HYP3R-08/AuthLog/(commit log)

2026-03-31 integrazione distanza e led
2026-07-16 feat(supabase): add verify-access Edge Function and schema
    The function verifies a UUID against the authorized table and records the
    attempt, keeping the service role key server-side. Devices authenticate
    with a rotatable device token.
    Adds the database schema and the Row Level Security policies.
2026-07-16 refactor(firmware)!: split sketches per board and harden
    Each sketch now lives in its own folder, as the Arduino toolchain requires.
    The STM32 sends UUID:<uuid> and the gateway replies AUTH:OK|NO|ERR, so the
    reader drives the LEDs and the lock from the verdict. AUTH:ERR is kept
    distinct from AUTH:NO.
    The gateway calls the verify-access Edge Function instead of PostgREST,
    validates the UUID grammar before use, parses the JSON response, verifies
    TLS against a pinned root CA after an NTP sync, and recovers from network
    loss by restarting. Fixed buffers replace String on the hot paths.
    BREAKING CHANGE: requires verify-access to be deployed and secrets.h to be
    configured.
    [esp8266-gateway.ino, stm32-reader.ino]
2026-07-16 docs: update README for the current architecture
    Documents the Edge Function flow, the UART protocol, the repository
    layout, the setup steps for each component, and planned future work.
    Fixes the documentation link: GitHub is case-sensitive and the file did
    not match the link, which returned 404.
2026-07-16 docs: add photos and demo GIF
    Shows the assembled reader, its internals, and the enrolment flow: the app
    writes the user UUID to the phone's NFC tag, which then acts as the badge.
    Also notes that the relay pin is unwired on the build.
2026-10-03 fix(reader): move gateway link to USART6 and consume tag after read
    On the Nucleo-F401RE, Serial2 is the ST-LINK port, so the gateway now
    uses USART6 on PA11/PA12. The UUID in the ST25DV memory is overwritten
    once read, so each phone write produces a single verification.
    [stm32-reader.ino]
2026-10-03 fix(gateway): request HTTP/1.0 so the JSON body arrives unchunked
    [esp8266-gateway.ino]
2026-10-03 docs: document UART wiring, EAS env vars and function deploy flags
    Also ignore the Supabase CLI local state directory.
2026-10-03 feat(mobile): redesign the app and add the admin access log
    Dark theme built on shared design tokens, Space Grotesk and Inter type,
    and reusable components. Home shows the NFC pass with live feedback;
    administrators get an access log grouped by day, filterable by verdict,
    with pull to refresh and pagination. A saved session skips the login.
2026-10-05 feat(gateway): add a UNIHIKER K10 gateway with screen and sound
    Same UART protocol and Edge Function as the ESP8266 gateway, which stays
    in place. The K10 greets the person when the reader sees them, shows the
    verdict with the user's name, and plays a sound for each outcome.
2026-10-08 feat(gateway): add K10 console diagnostics and a presence delay
    Every line from the reader is echoed on the USB console, and the same
    lines typed there are handled as if they came from the reader, so the
    gateway can be tested without the STM32. The greeting waits for 1.5 s
    of presence and is silent; only verdicts play a sound.
2026-10-19 docs: show the current K10 enclosure in the README
